InnoGreenTech/Linky_solar_save_energy/README.md

# Linky_solar_save_energy
This is a controller of a hot water tank, it is able to read TIC linky and to adjust the power to absord the solar production.
