InnoGreenTech/Linky_solar_save_energy/controller_water_ballon_linky_connected/Couvercle_hot_tank_water_controller.stl

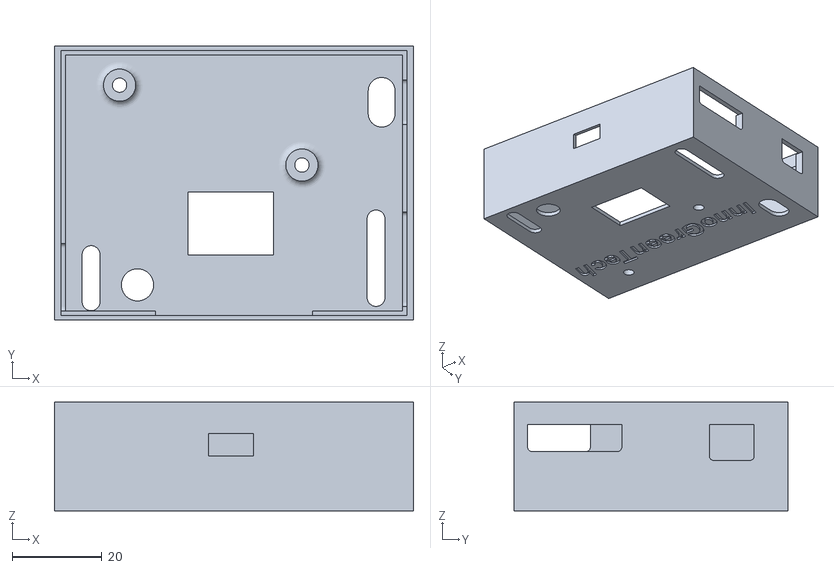
[picture p1: CAD file, 2021-01-16]
controller_water_ballon_linky_connected/Couvercle_hot_tank_water_controller.stl
80.0 x 61.0 x 24.2
