InnoGreenTech/Linky_solar_save_energy/controller_water_ballon_linky_connected/hot_water_tanker_controller.FCStd

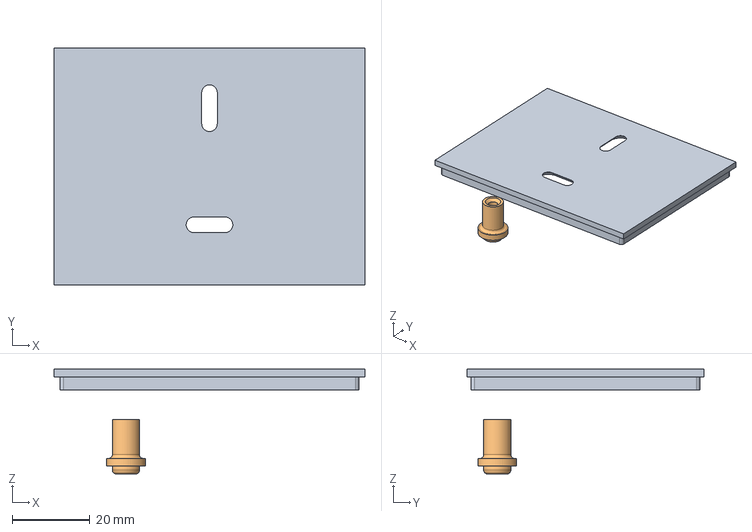
[picture p3: CAD file, 2021-01-16]
controller_water_ballon_linky_connected/hot_water_tanker_controller.FCStd
80.0 x 61.0 x 27.0 mm
Base
Bouton
