InnoGreenTech/Linky_solar_save_energy/controller_water_ballon_linky_connected/Bouton_hot_tank_water_controller.stl

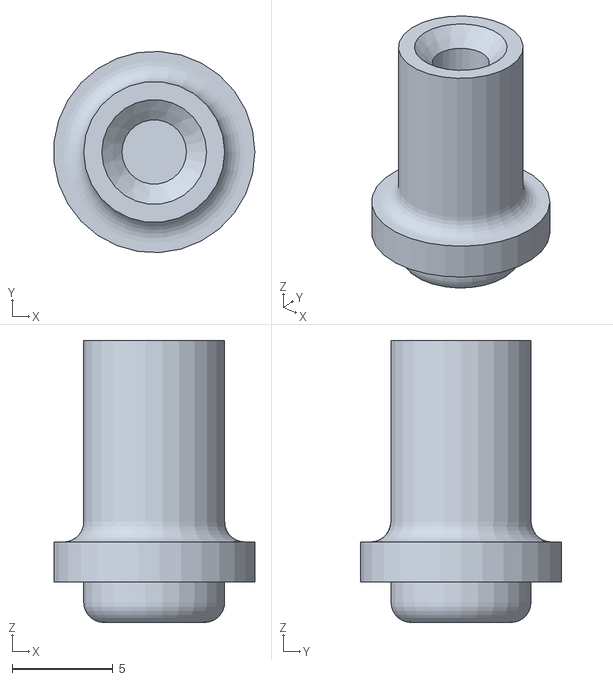
[picture p4: CAD file, 2021-01-16]
controller_water_ballon_linky_connected/Bouton_hot_tank_water_controller.stl
9.97 x 9.99 x 14.0
