InnoGreenTech/Linky_solar_save_energy/controller_water_ballon_linky_connected/controller_water_ballon_linky_connected.step

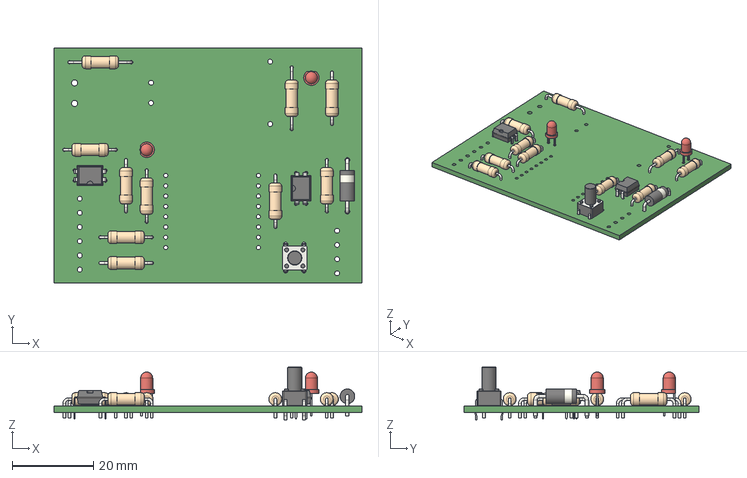
[picture p5: CAD file, 2021-01-16]
controller_water_ballon_linky_connected/controller_water_ballon_linky_connected.step
76.0 x 58.0 x 13.0 mm
