InnoGreenTech/Linky_solar_save_energy/controller_water_ballon_linky_connected/controller_water_ballon_linky_connected.kicad_pcb

## KiCad design controller_water_ballon_linky_connected/controller_water_ballon_linky_connected.kicad_pcb (2021-01-16)

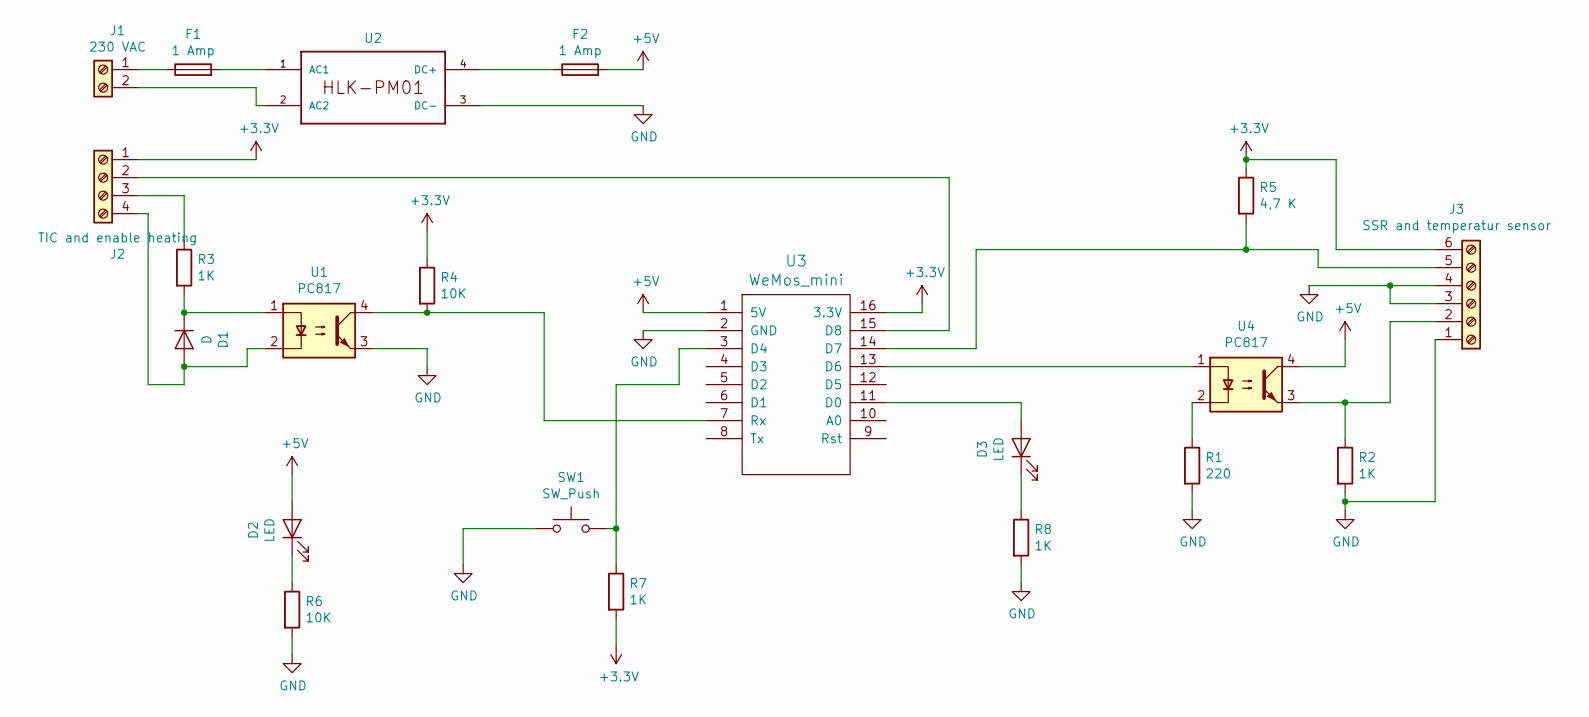
[picture p6: schematic controller_water_ballon_linky_connected.sch]

Parts:
D1: D; D_DO-15_P12.70mm_Horizontal
D2, D3: LED; LED_D3.0mm
F1, F2: 1 Amp; R_Axial_DIN0309_L9.0mm_D3.2mm_P15.24mm_Horizontal
J1: 230 VAC; TerminalBlock_bornier-2_P5.08mm
J2: TIC and enable heating; TerminalBlock_Phoenix_PT-1,5-4-3.5-H_1x04_P3.50mm_Horizontal
J3: SSR and temperatur sensor; TerminalBlock_Phoenix_PT-1,5-6-3.5-H_1x06_P3.50mm_Horizontal
R1: 220; R_Axial_DIN0309_L9.0mm_D3.2mm_P12.70mm_Horizontal
R2, R3, R7, R8: 1K; R_Axial_DIN0309_L9.0mm_D3.2mm_P12.70mm_Horizontal
R4, R6: 10K; R_Axial_DIN0309_L9.0mm_D3.2mm_P12.70mm_Horizontal
R5: 4,7 K; R_Axial_DIN0309_L9.0mm_D3.2mm_P12.70mm_Horizontal
SW1: SW_Push; SW_PUSH_6mm_H9.5mm
U1, U4: PC817; DIP-4_W7.62mm
U2: HLK-PM01
U3: WeMos_mini; D1_mini_board

Connections:
+3V3: J2.1, J3.6, R4.1, R5.1, R7.2, U3.16 (3.3V)
+5V: D2.2 (A), F2.2, U3.1 (5V), U4.4
GND: J3.1, J3.3, J3.4, R1.2, R2.2, R6.2, R8.2, SW1.1, U1.3, U2.3 (DC-), U3.2 (GND)
unnamed: D1.1 (K), R3.2, U1.1
unnamed: D1.2 (A), J2.4, U1.2
unnamed: D2.1 (K), R6.1
unnamed: D3.1 (K), R8.1
unnamed: D3.2 (A), U3.11 (D0)
unnamed: F1.1, J1.1
unnamed: F1.2, U2.1 (AC1)
unnamed: F2.1, U2.4 (DC+)
unnamed: J1.2, U2.2 (AC2)
unnamed: J2.2, U3.15 (D8)
unnamed: J2.3, R3.1
unnamed: J3.2, R2.1, U4.3
unnamed: J3.5, R5.2, U3.14 (D7)
unnamed: R1.1, U4.2
unnamed: R4.2, U1.4, U3.7 (Rx)
unnamed: R7.1, SW1.2, U3.3 (D4)
unnamed: U3.13 (D6), U4.1

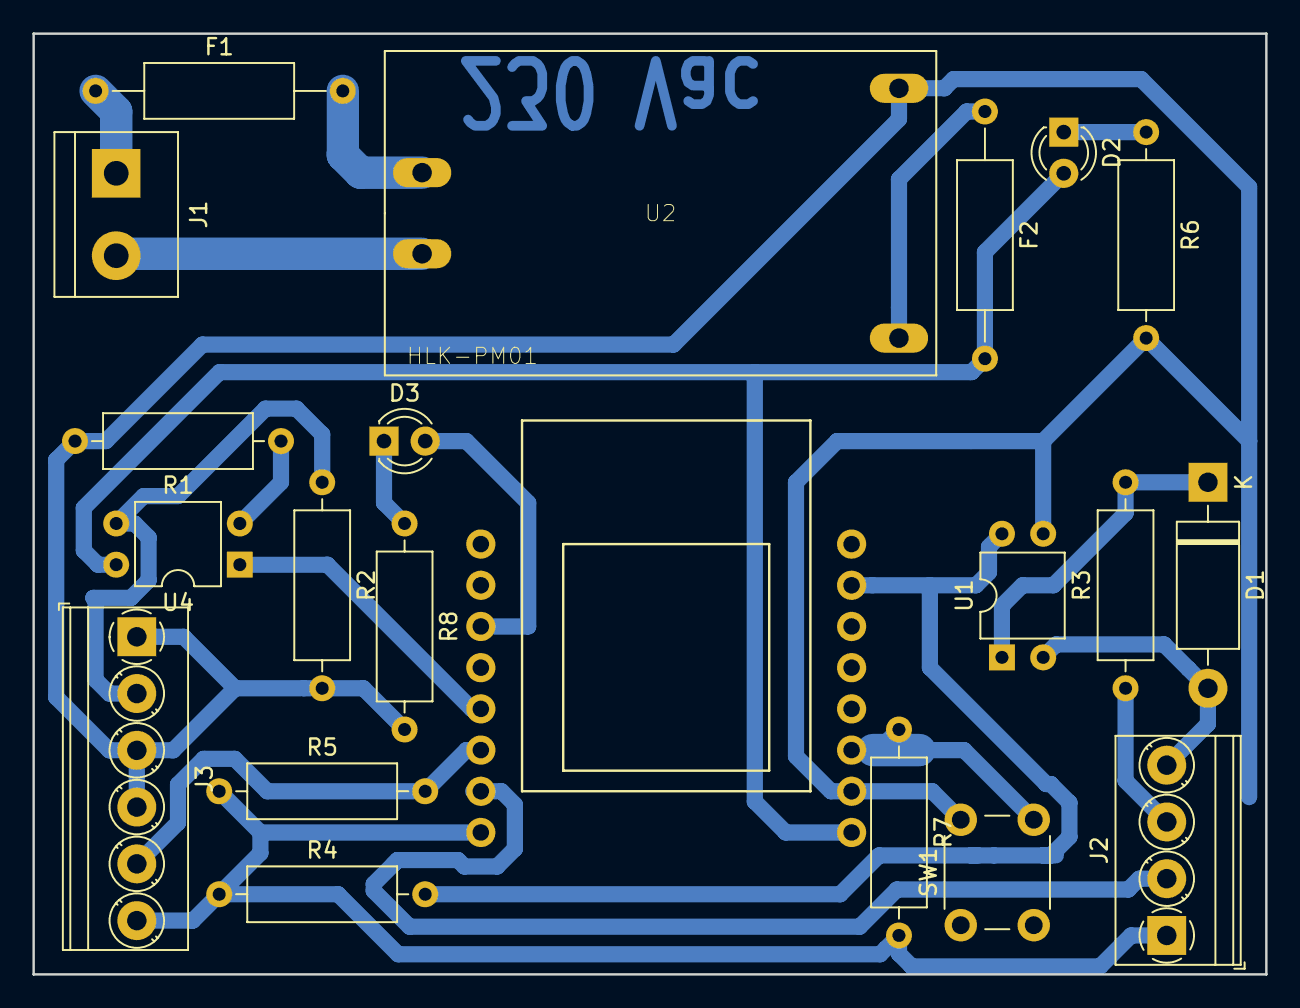
[picture p7: board controller_water_ballon_linky_connected.kicad_pcb from above]

Board: 2 copper layers, 76.0 x 58.0 mm, 21 parts (1 on the bottom side), 20 nets.
