InnoGreenTech/Linky_solar_save_energy/(commit log)

2021-01-17 improve the heating beavior
2021-04-23 diseable PID and add intensity control to adjust power recovery
