InnoGreenTech/Linky_solar_save_energy/(notices)

Notices in the files:
Linky_hot_water_controller/Linky_hot_water_controller.ino:
This program is free software: you can redistribute it and/or modify
it under the terms of the GNU General Public License as published by
the Free Software Foundation, either version 3 of the License.
